NT7S/TwinTCPO/media/Eli_Amogus.pdf

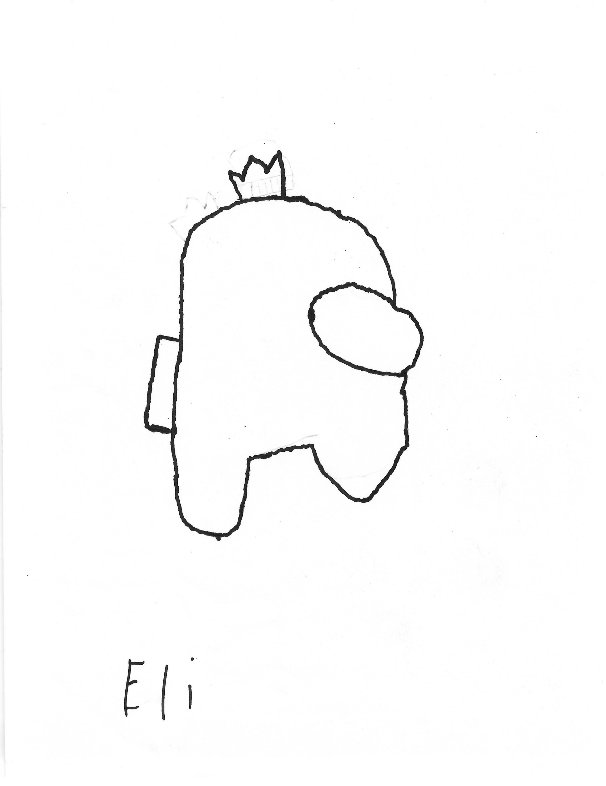
[picture p1: page 1]
