NT7S/TwinTCPO/media/Eli_Amogus_Label-ditherlicious.png

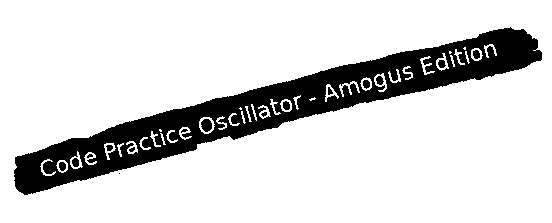
media/Eli_Amogus_Label-ditherlicious.png
