NT7S/TwinTCPO/media/Eli_Amogus_Silkscreen_Visor.tif

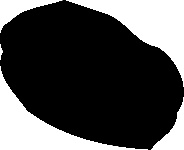
media/Eli_Amogus_Silkscreen_Visor.tif
