NT7S/TwinTCPO/media/Eli_Amogus_Silkscreen_Visor_Back.tif

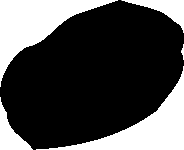
media/Eli_Amogus_Silkscreen_Visor_Back.tif
