NT7S/TwinTCPO/media/sus_morse-ditherlicious.png

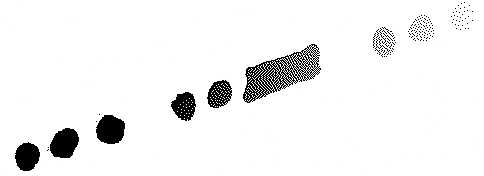
media/sus_morse-ditherlicious.png
