NT7S/TwinTCPO/media/Eli_Amogus_Silkscreen.dxf

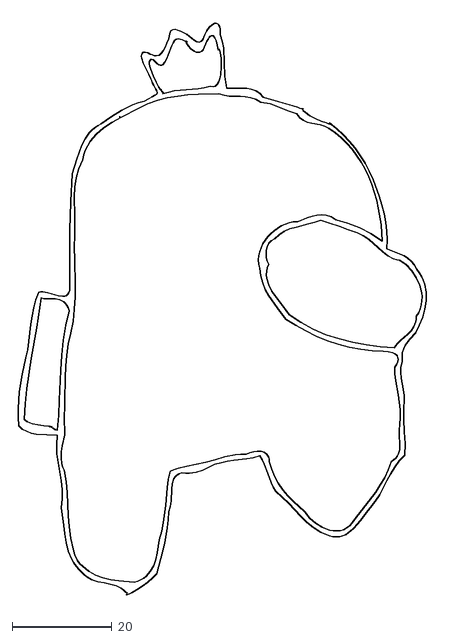
[picture p6: CAD file, 2023-12-28]
media/Eli_Amogus_Silkscreen.dxf
83.5 x 117.1
