NT7S/TwinTCPO/media/Eli_Amogus_Board_Outline.dxf

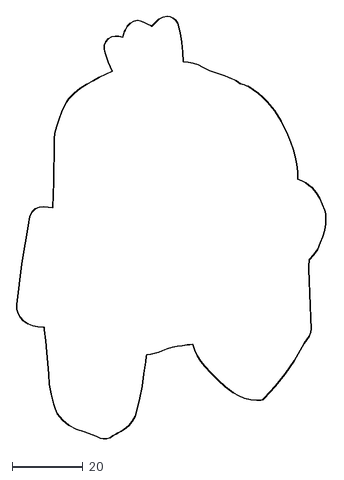
[picture p7: CAD file, 2023-12-28]
media/Eli_Amogus_Board_Outline.dxf
88.1 x 120.0
