NT7S/TwinTCPO/pcb/TwinTCPO.pdf

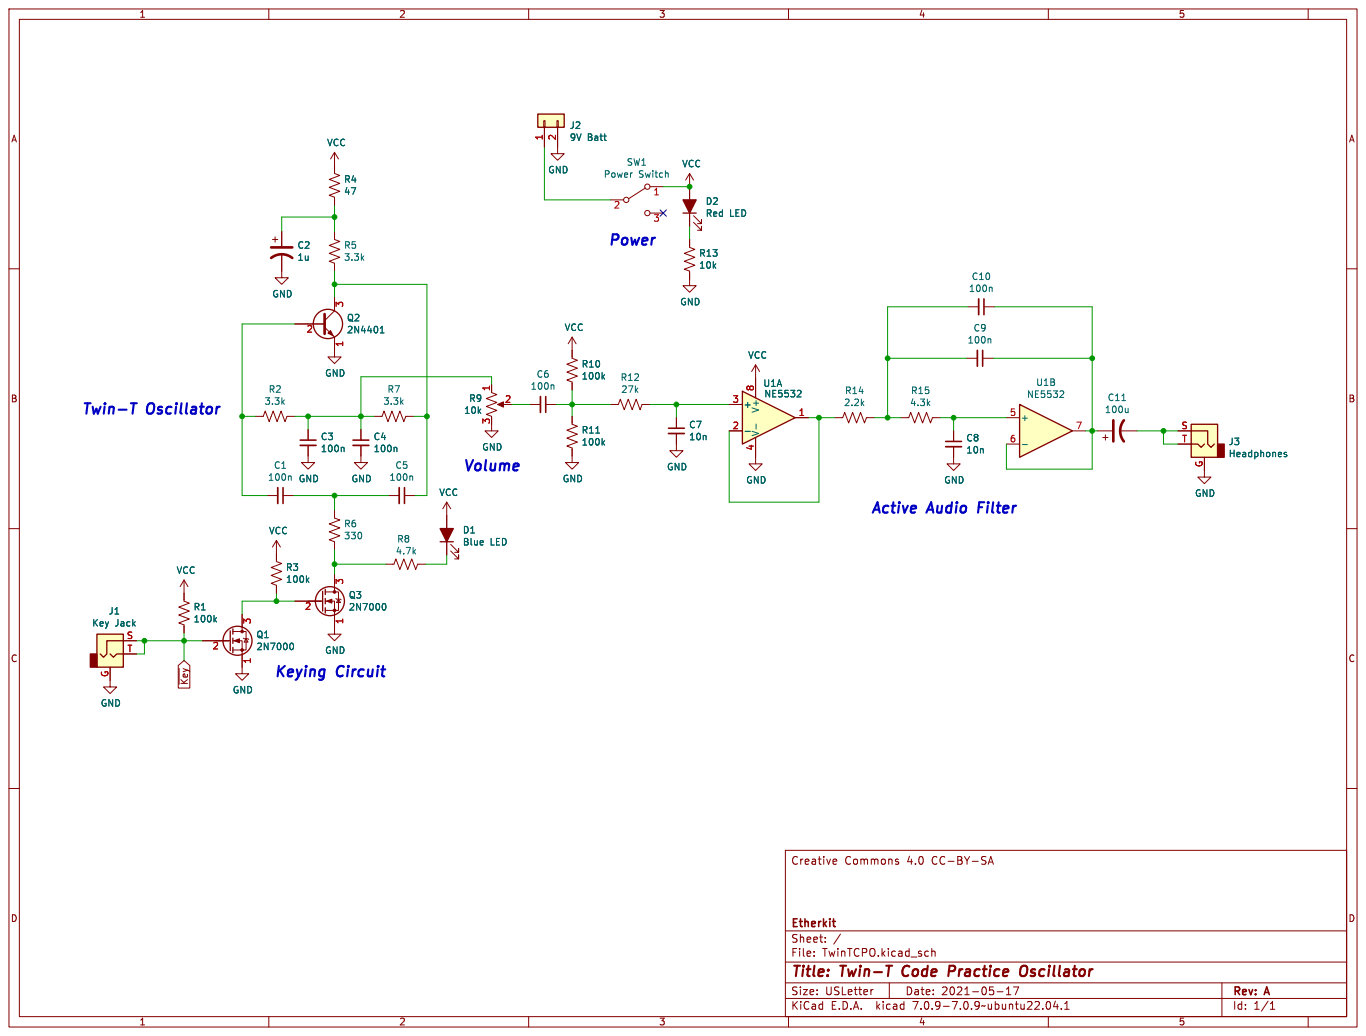
[picture p8: page 1]

Id: 1/1 Title: Twin-T Code Practice Oscillator File: TwinTCPO.kicad_sch Sheet: / Etherkit Creative Commons 4.0 CC-BY-SA
