NT7S/TwinTCPO/pcb/TwinTCPO.kicad_pcb

## KiCad design pcb/TwinTCPO.kicad_pcb (2023-12-28)

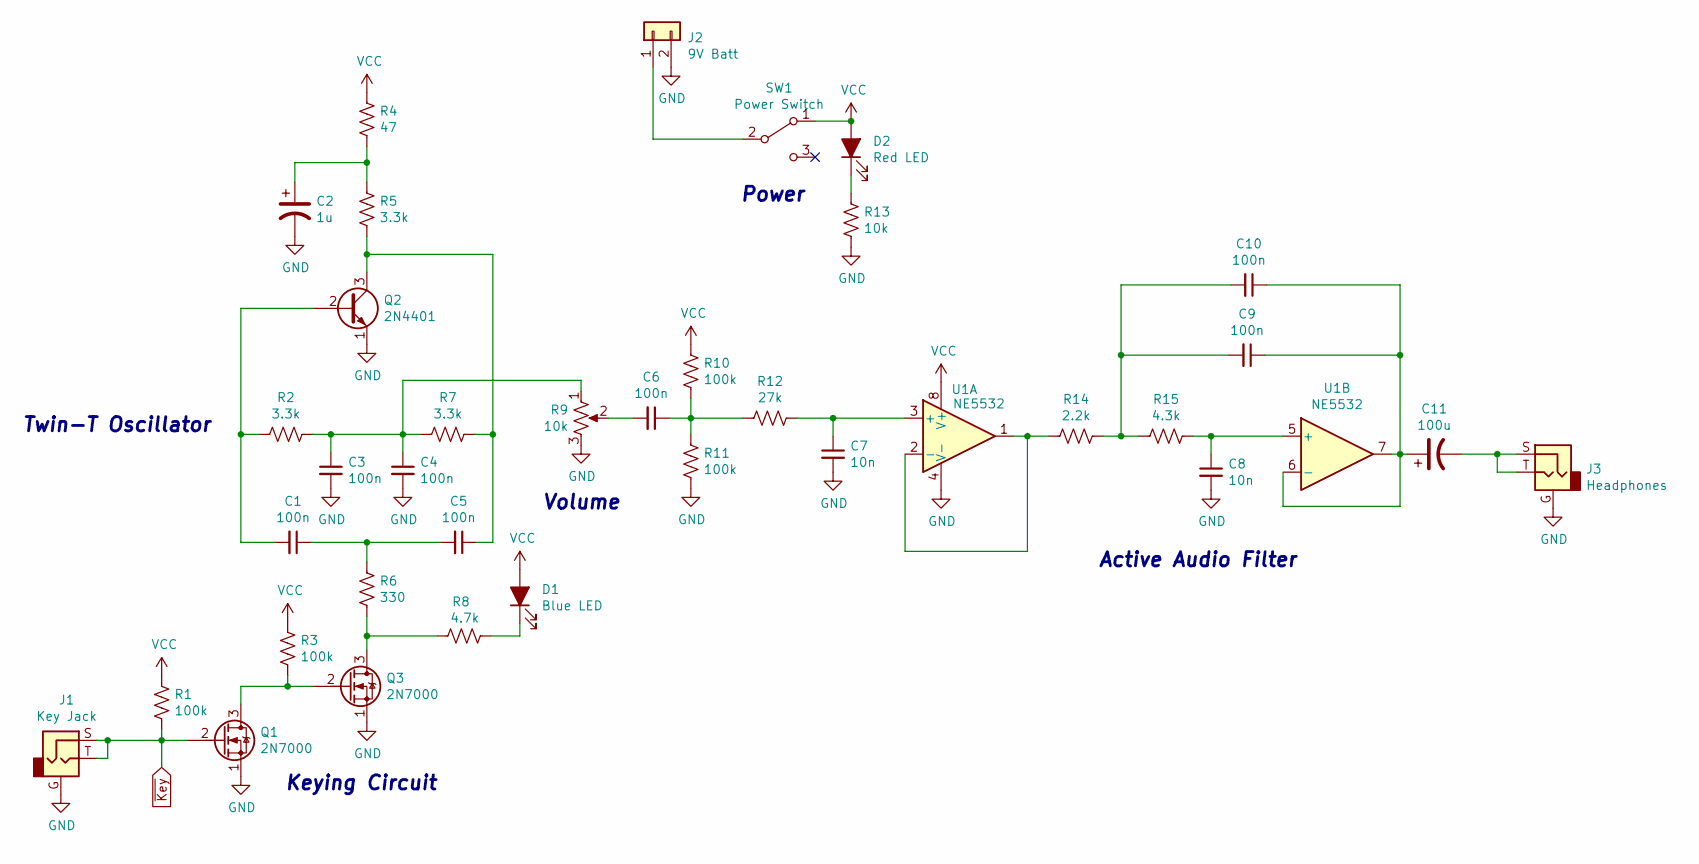
[picture p9: schematic TwinTCPO.kicad_sch, Twin-T Code Practice Oscillator]

Parts:
C1, C3, C4, C5, C6, C9, C10: 100n; C_Disc_D4.3mm_W1.9mm_P5.00mm
C2: 1u; CP_Radial_D5.0mm_P2.00mm
C7, C8: 10n; C_Disc_D4.3mm_W1.9mm_P5.00mm
C11: 100u; CP_Radial_D5.0mm_P2.00mm
D1: Blue LED; Kingbright_AA3528QBS_D09
D2: Red LED; LED_D5.0mm
J1: Key Jack; Kycon_STX-3120-3B
J2: 9V Batt; Eagle_12BH611-GR
J3: Headphones; Kycon_STX-3120-3B
Q1, Q3: 2N7000; TO-92_Inline
Q2: 2N4401; TO-92_Inline
R1, R3, R10, R11: 100k; R_Axial_DIN0207_L6.3mm_D2.5mm_P7.62mm_Horizontal
R2, R5, R7: 3.3k; R_Axial_DIN0207_L6.3mm_D2.5mm_P7.62mm_Horizontal
R4: 47; R_Axial_DIN0207_L6.3mm_D2.5mm_P7.62mm_Horizontal
R6: 330; R_Axial_DIN0207_L6.3mm_D2.5mm_P7.62mm_Horizontal
R8: 4.7k; R_Axial_DIN0207_L6.3mm_D2.5mm_P7.62mm_Horizontal
R9: 10k; Piher_N6L25T3N-103-3030
R12: 27k; R_Axial_DIN0207_L6.3mm_D2.5mm_P7.62mm_Horizontal
R13: 10k; R_Axial_DIN0207_L6.3mm_D2.5mm_P7.62mm_Horizontal
R14: 2.2k; R_Axial_DIN0207_L6.3mm_D2.5mm_P7.62mm_Horizontal
R15: 4.3k; R_Axial_DIN0207_L6.3mm_D2.5mm_P7.62mm_Horizontal
SW1: Power Switch; C&K_OS102011MS2QN1
U1: NE5532; DIP-8_W7.62mm_LongPads

Connections:
GND: C2.2, C3.2, C4.2, C7.2, C8.2, J1.G, J2.2, J3.G, Q1.1 (S), Q2.1 (E), Q3.1 (S), R9.3, R11.2, R13.2, U1.4 (V-)
unnamed: C1.1, C5.2, R6.1
unnamed: C1.2, Q2.2 (B), R2.1
unnamed: C2.1, R4.2, R5.1
unnamed: C3.1, C4.1, R2.2, R7.1, R9.1
unnamed: C5.1, Q2.3 (C), R5.2, R7.2
unnamed: C6.1, R10.2, R11.1, R12.1
unnamed: C6.2, R9.2
unnamed: C7.1, R12.2, U1.3 (+)
unnamed: C8.1, R15.2, U1.5 (+)
unnamed: C9.1, C10.1, C11.1, U1.6 (-), U1.7
unnamed: C9.2, C10.2, R14.2, R15.1
unnamed: C11.2, J3.S, J3.T
unnamed: D1.1 (K), R8.1
unnamed: D2.1 (K), R13.1
unnamed: J2.1, SW1.2 (B)
unnamed: Q1.3 (D), Q3.2 (G), R3.2
unnamed: Q3.3 (D), R6.2, R8.2
unnamed: R14.1, U1.1, U1.2 (-)
VCC: D1.2 (A), D2.2 (A), R1.1, R3.1, R4.1, R10.1, SW1.1 (A), U1.8 (V+)
~Key: J1.S, J1.T, Q1.2 (G), R1.2

Notes on the sheet:
Power
Keying Circuit
Volume
Active Audio Filter
Twin-T Oscillator

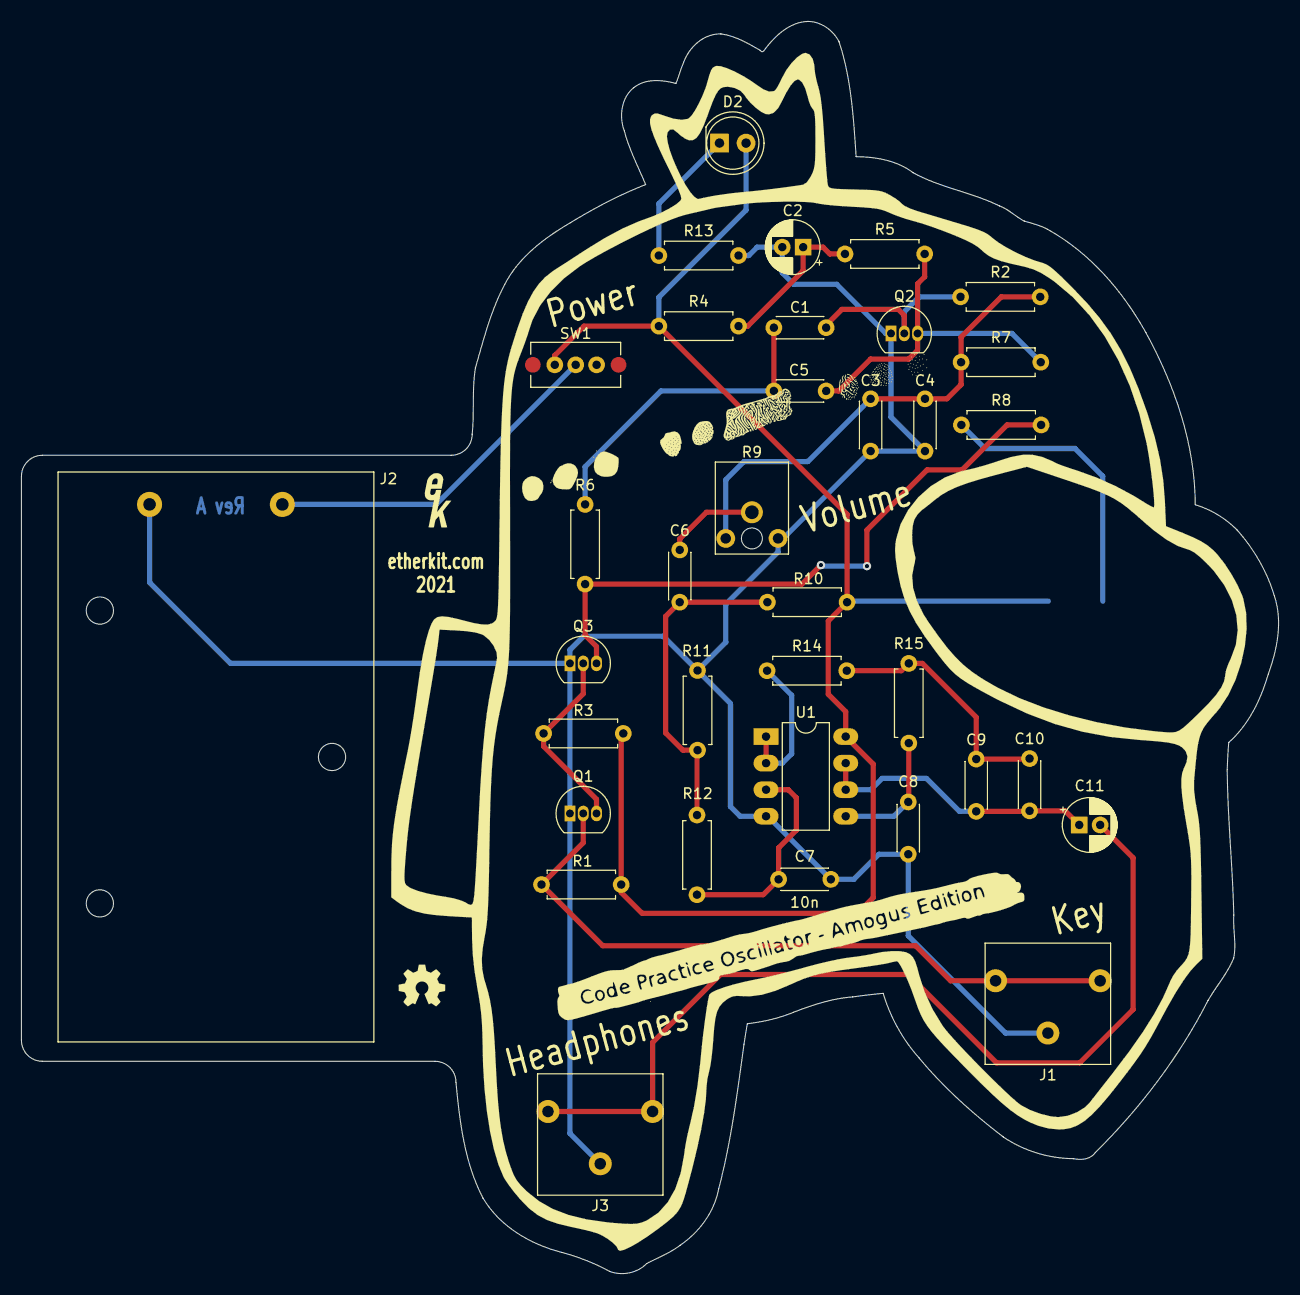
[picture p10: board TwinTCPO.kicad_pcb from above]

Board: 2 copper layers, 120.2 x 119.7 mm, 37 parts (1 on the bottom side), 21 nets.

Other parts of the board:
Ref**: Val**; EtherkitLogoSmall
