NT7S/TwinTCPO/(commit log)

2026-11-02 Add README, BOM, license, and rev A notes
    README was a single word with no build information. Add a proper
    overview, specs, build notes, and repository map.
    BOM.csv lists the board as fabricated (rev A, 2021), with a Notes
    column flagging the five references whose schematic value differs.
    LICENSE: the schematic title block declares CC BY-SA 4.0 but no
    license file was present. Add the full text.
    docs/REV-A-NOTES.md records the schematic/board discrepancies, the
    missing supply decoupling and ground plane, and DFM observations, so
    builders know which file to trust.
2026-11-02 Correct electrical claims in rev A notes after review
    Engineering review found three errors in the discrepancy analysis:
    - C11 and R6 both resolve the opposite way from my first reading. The
    schematic is correct on both; the board is wrong. 1 uF into 32 ohms
    corners at 4.97 kHz and costs ~20 dB at the 480 Hz tone. R6 3.3k
    matches the twin-T and 330 ohms detunes it upward, so the board's
    3.3k is right.
    - C2 is the Q2 collector supply filter (VCC -> R4 47R -> C2 -> R5 ->
    collector), not the mid-rail bias node. Mid-rail is the R10/R11
    divider with C6/C7. The oscillator collector is filtered, so the
    'shares the raw 9 V rail' framing was overstated; VCC itself still
    has no capaci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
